luoluoluo312/STM32-TFT-Game-Console/user/photo.c

/* 本文件由 my_app/gen_photo.py 自动生成，不要手改 */
#include "photo.h"

const uint16_t PHOTO_PAL[PHOTO_COLORS] = {
    0xCF9D,0xCF7C,0xCF7C,0xC77D,0xC77D,0xCF5C,0xCF5C,0xBF5D,
    0xBF5C,0xBF5C,0xB75C,0xB73C,0xAF3C,0xAF1C,0xAF1C,0xA71C,
    0xA71C,0xA71C,0xD678,0xCE56,0xCE37,0xDEAC,0xD653,0xDE6B,
    0xDE4A,0xDE2A,0xD62A,0xA6FC,0x9EFC,0xCE56,0xBE78,0xCE55,
    0xBE74,0xC635,0x9EFC,0x9EFC,0x9EDC,0x96FC,0x96FC,0x96DC,
    0x96DC,0x8EBC,0x96BC,0x8EBB,0x8EBC,0x8EBC,0x86BC,0x869C,
    0x869C,0x869C,0x867C,0x867B,0x7E7B,0x867B,0x867B,0x7E7B,
    0x7E7B,0x7E5B,0x7E5B,0x865A,0x767B,0x765B,0x765B,0x765B,
    0x765B,0x763B,0x6E3B,0x763B,0x6E3B,0xC616,0xCE10,0xD60A,
    0xCDEA,0xD609,0xD609,0xD609,0xD5E9,0xCDC9,0xD5E9,0xD5C9,
    0xCDE9,0xCDC9,0xCDA9,0xC5A8,0xC588,0xC615,0xC614,0xC5F4,
    0xC5D3,0xBDD3,0xB592,0x95F9,0x9DB6,0xC5AB,0xC5A9,0xC589,
    0xC568,0xBD8B,0xBD6A,0x8DAA,0x8D88,0x7DD9,0x7D91,0x8588,
    0x8568,0x8588,0x8568,0x8588,0x8588,0x8588,0x8588,0x8568,
    0x8587,0x8567,0x8567,0x8587,0x8587,0x8567,0x8587,0x8587,
    0x8587,0x8587,0x8587,0x8587,0x8587,0x8567,0x8567,0x8567,
    0x8567,0x8567,0x8567,0x7D67,0xB553,0xB52E,0xBD48,0xBD47,
    0xBD07,0xBD07,0xBCE7,0xB4E7,0xB4C7,0xB4C7,0xAD0F,0x9D11,
    0x9529,0x8547,0xACC7,0xACA6,0x8567,0x8D07,0x8548,0x8547,
    0x7D47,0x7D47,0x8567,0x7D67,0x7D47,0x7D67,0x8547,0x7D47,
    0x8547,0x7D47,0x6D37,0x752A,0x7D48,0x7D28,0x7D47,0x7D27,
    0x7D47,0x7D27,0x7D47,0x7D47,0x7D47,0x7D27,0x7527,0x7507,
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
     56, 56, 56, 56, 56, 56, 56, 56, 55, 55, 55, 55, 55, 55, 56, 58, 58, 57, 57, 63, 63, 63, 63, 63,
     61, 61, 60, 60, 61, 65, 65, 65, 66, 66, 65, 67, 67, 67, 67, 65, 65, 65, 65, 65, 65, 64, 61, 61,
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
};
