luoluoluo312/STM32-TFT-Game-Console/user/sprites.c

/* 本文件由 my_app/gen_sprites.py 自动生成，不要手改 */
#include "sprites.h"

const uint16_t SPRITE_PALETTE[SPRITE_PALETTE_COUNT] = {
    0x0000, 0x10C6, 0x1B14, 0x3E5E, 0xEFDF, 0xFF0C, 0xFB84, 0xFE86, 0xA29F, 0x4710, 0x3188, 0xC61A, 0xE186, 0x8082, 0x96DF, 0x0000
};

const uint8_t SPR_PLAYER[3][PLAYER_W * PLAYER_H] = {
    {   /* 正常 */
     0, 0, 0, 0, 1, 3, 1, 0, 0, 0, 0, 0, 0, 0, 0, 1,
     3, 1, 0, 0, 0, 0, 0, 0, 0, 1, 3, 3, 3, 1, 0, 0,
     0, 0, 0, 0, 1, 3, 3, 3, 1, 0, 0, 0, 0, 0, 1, 3,
     3, 3, 3, 3, 1, 0, 0, 0, 0, 1, 3, 5, 5, 3, 3, 1,
     0, 0, 0, 1, 3, 3, 3, 3, 3, 3, 3, 1, 0, 0, 1, 3,
     3, 3, 3, 3, 3, 3, 1, 0, 1, 3, 3, 3, 3, 3, 3, 3,
     3, 3, 1, 4, 3, 1, 3, 3, 3, 3, 3, 1, 3, 4, 1, 1,
     1, 6, 1, 1, 1, 6, 1, 1, 1,
    },
    {   /* 左倾 */
     0, 0, 0, 0, 1, 3, 1, 0, 0, 0, 0, 0, 0, 0, 0, 1,
     3, 1, 0, 0, 0, 0, 0, 0, 0, 1, 3, 3, 3, 1, 0, 0,
     0, 0, 0, 0, 1, 3, 3, 3, 1, 0, 0, 0, 0, 0, 1, 3,
     3, 3, 3, 3, 1, 0, 0, 0, 1, 1, 3, 5, 5, 3, 3, 1,
     0, 0, 1, 3, 3, 3, 3, 3, 3, 3, 1, 0, 0, 1, 3, 3,
     3, 3, 3, 3, 3, 1, 0, 0, 3, 3, 3, 3, 3, 3, 3, 3,
     3, 1, 0, 3, 1, 3, 3, 3, 3, 3, 1, 3, 4, 1, 1, 1,
     6, 1, 1, 1, 6, 1, 1, 1, 0,
    },
    {   /* 右倾 */
     0, 0, 0, 0, 1, 3, 1, 0, 0, 0, 0, 0, 0, 0, 0, 1,
     3, 1, 0, 0, 0, 0, 0, 0, 0, 1, 3, 3, 3, 1, 0, 0,
     0, 0, 0, 0, 1, 3, 3, 3, 1, 0, 0, 0, 0, 0, 1, 3,
     3, 3, 3, 3, 1, 0, 0, 0, 0, 1, 3, 5, 5, 3, 3, 1,
     1, 0, 0, 0, 1, 3, 3, 3, 3, 3, 3, 3, 1, 0, 0, 1,
     3, 3, 3, 3, 3, 3, 3, 1, 0, 1, 3, 3, 3, 3, 3, 3,
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
     0, 0, 0, 0,12,12,12,12,12, 0,12,12, 0, 0, 0, 0,
     0, 0, 0, 0, 0,12,12,12, 0, 0,12,12,12, 0, 0, 0,
     0, 0, 0, 0, 0, 0,12,12,12,12, 0,12,12,12, 0, 0,
     0, 0, 0, 0, 0, 0, 0,12,12, 0, 0,12,12,12,12,12,
     0, 0, 0, 0, 0, 0, 0,12,12,12, 0,12,13,12,12,12,
    12,12, 0, 0, 0, 0, 0,12,12, 0,12, 0,13,13, 0,12,
    12,12,12,12,12,12,12,12,12, 0,12,12,12, 0,13, 0,
    12, 0,12, 0,12,12,12,12,12,12,12, 0, 0,13,13,13,
     0,13,12, 0,12, 0,12, 0,12, 0, 0, 0, 0,13,13,13,
    13,13,13,13, 0,12, 0,12,12,12, 0,12,13,13, 0,13,
    13,
    },
};
